HexabitzPlatform/H10R4x-Hardware/README.md

# H10R4x-Hardware
Hexabitz Thumb Joystick Module Hardware Design
