HexabitzPlatform/H10R4x-Hardware/Documentation/H10R4 Schematics.pdf

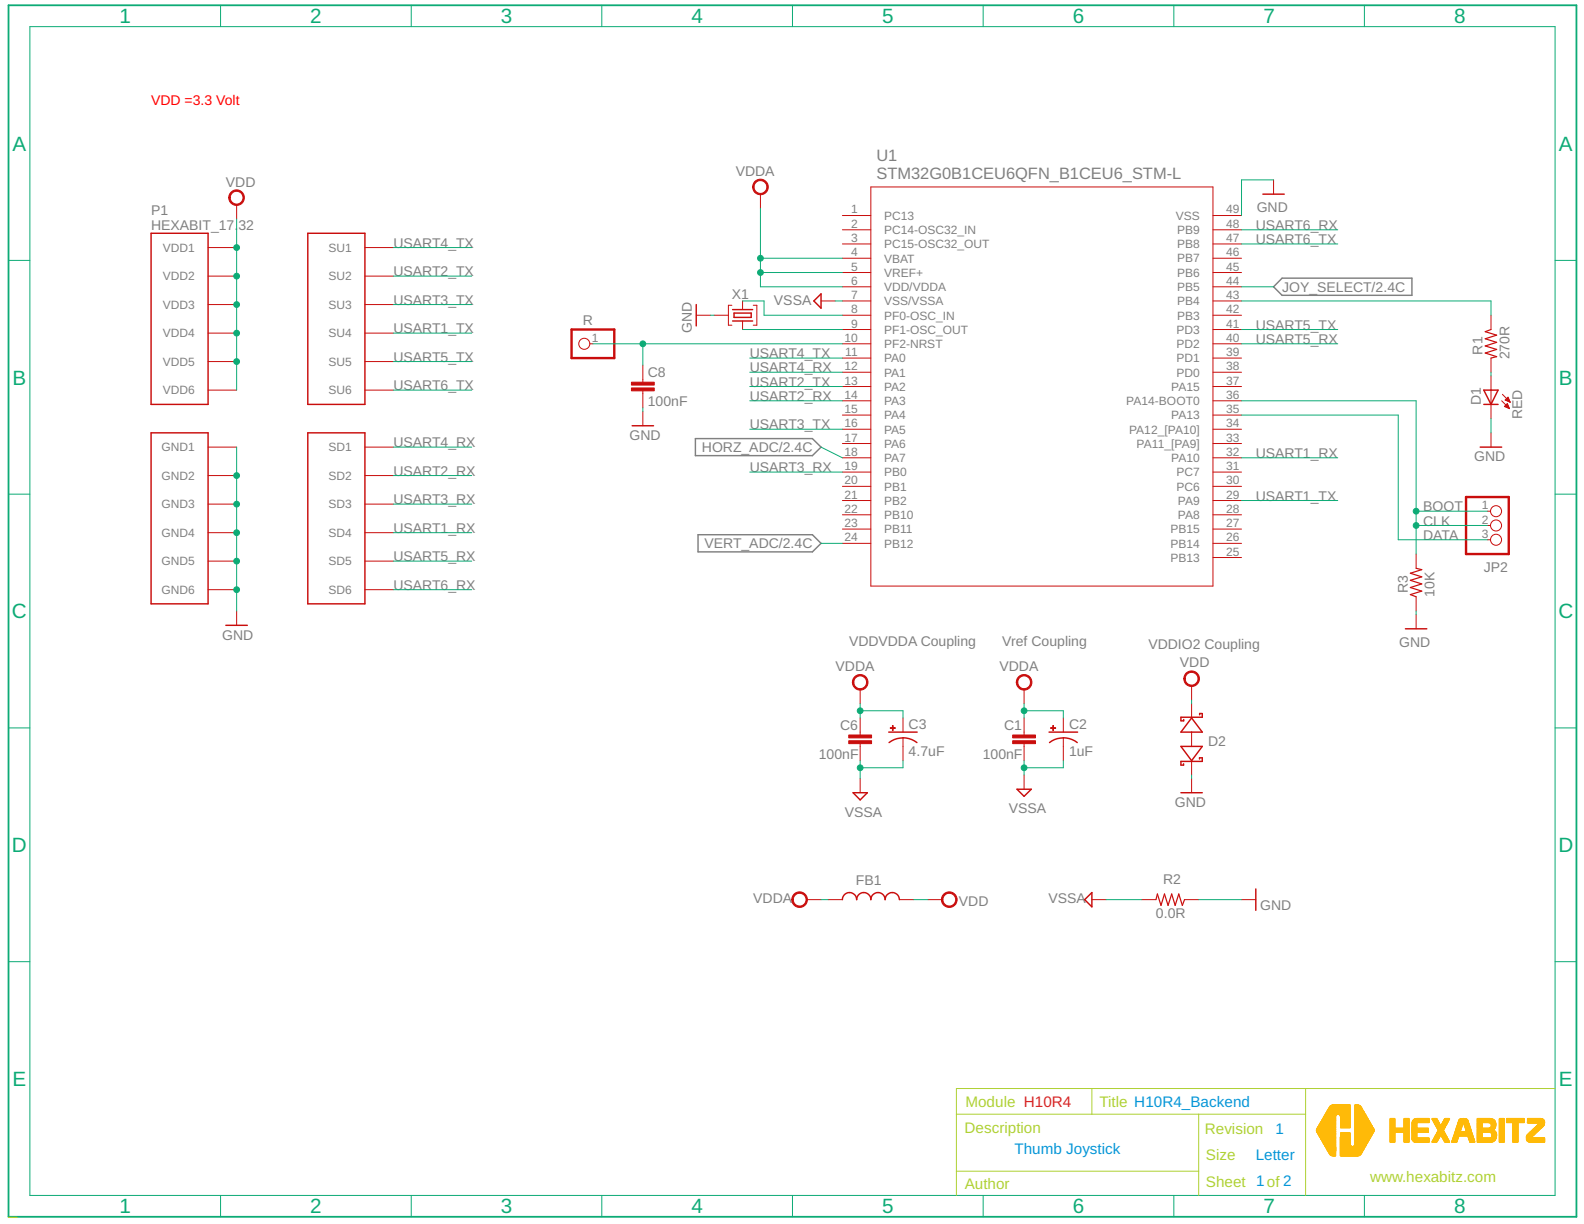
[picture p1: page 1]

Module Title Thumb Joystick | Revision Sheet Size Author Description of Letter 1 1 2

H10R4 | H10R4_Backend | www.hexabitz.com

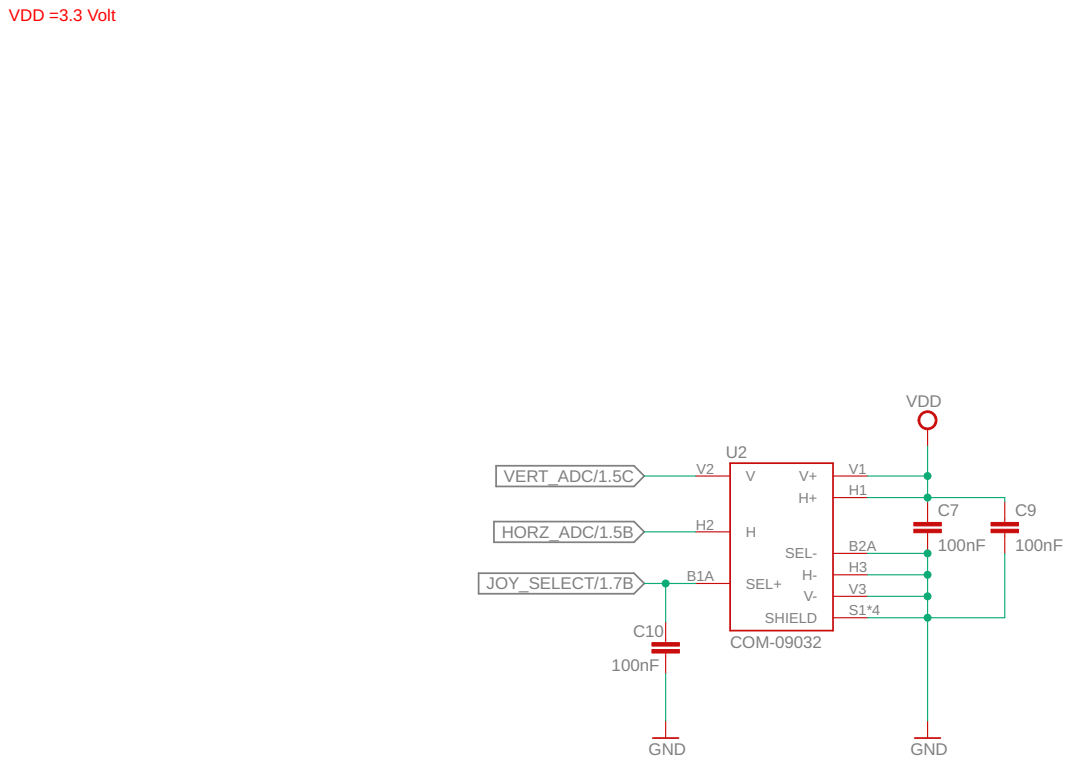
[picture p2: page 2]

Module Title Thumb Joystick | Revision Sheet Size Author Description of Letter 1 2 2

H10R4 | H10R4_Frontend | www.hexabitz.com
