HexabitzPlatform/H10R4x-Hardware/Design/H10R4.brd

## EAGLE design Design/H10R4.brd (2025-01-26)

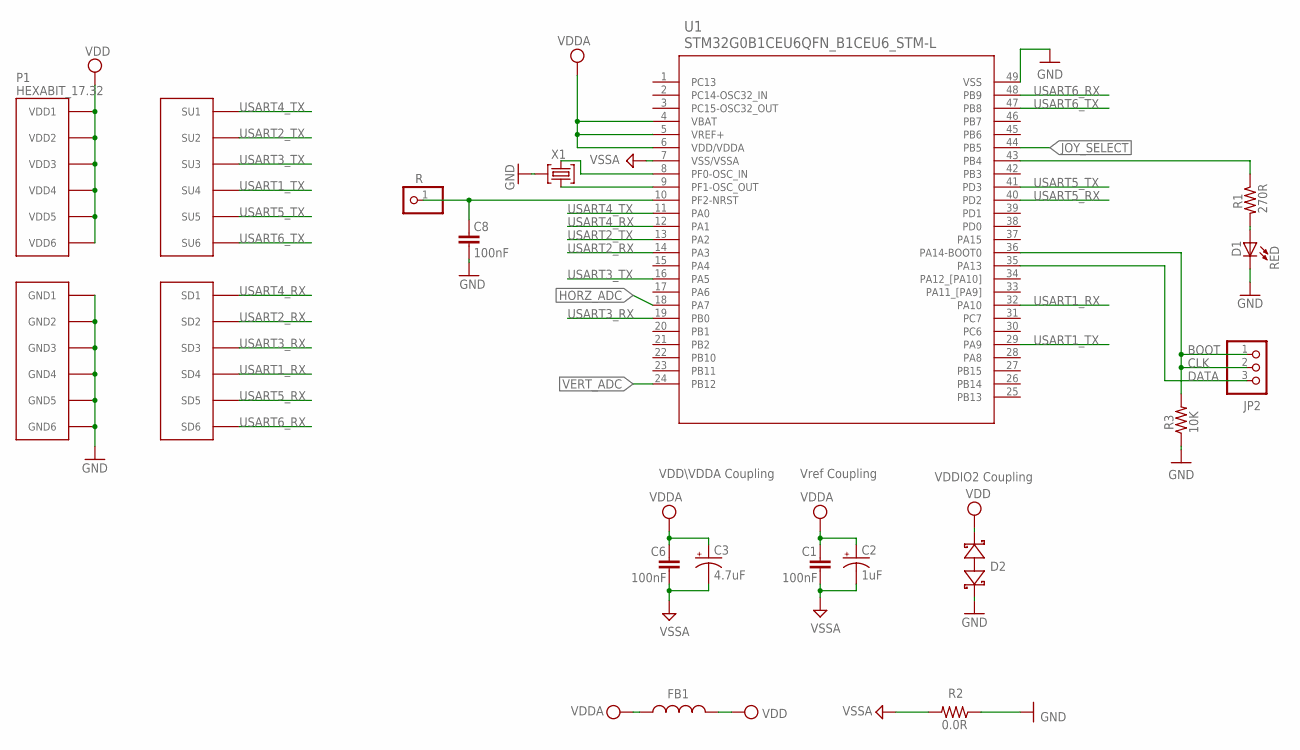
[picture p3: schematic H10R4.sch, sheet 1]

Parts:
C1, C6, C8: 100nF; C-0603
C2: 1uF; C-0805-POL
C3: 4.7uF; C-0805-POL
D1: RED; VLMS1300-GS08; MPN VLMS1300-GS08
D2: BOURNS_CDSOD323-T03SCBOURNS_CDSOD323-T03SC_0_0; BOURNS_CDSOD323-T03SC_0
FB1: FB-TDK_MMZ1608Y300B; MPN MMZ1608Y300B
JP2: PINHD-1X3; 1X03
P1: HEXABIT_17.32
R: R; 1X01
R1: 270R; R-0603
R2: 0.0R; R-0603; MPN RC0603JR-070RL
R3: 10K; R-0603
TRIMBLE-LOGO1: HEXA-LOGO
U1: STM32G0B1CEU6QFN_B1CEU6_STM-L; QFN_B1CEU6_STM-L
X1: XTALL_CSTCE8M00G52

Connections:
CLK: JP2.1, JP2.2, R3.2, U1.36 (PA14-BOOT0)
DATA: JP2.3, U1.35 (PA13)
GND: C8.2, D1.C, D2.1 (A), P1.PAD_PD7 (GND1), P1.PAD_PD8 (GND2), P1.PAD_PD9 (GND3), P1.PAD_PD10 (GND4), P1.PAD_PD11 (GND5), P1.PAD_PD12 (GND6), R2.1, R3.1, U1.49 (VSS), X1.P$2 (2); also elsewhere on the board
HORZ_ADC: U1.18 (PA7); also elsewhere on the board
JOY_SELECT: U1.44 (PB5); also elsewhere on the board
unnamed: R1.1, U1.43 (PB4)
unnamed: D1.A, R1.2
unnamed: C8.1, R.1, U1.10 (PF2-NRST)
unnamed: U1.9 (PF1-OSC_OUT), X1.P$1 (1)
unnamed: U1.8 (PF0-OSC_IN), X1.P$3 (3)
USART1_RX: P1.PAD_PD4 (SD4), U1.32 (PA10)
USART1_TX: P1.PAD_PU4 (SU4), U1.29 (PA9)
USART2_RX: P1.PAD_PD2 (SD2), U1.14 (PA3)
USART2_TX: P1.PAD_PU2 (SU2), U1.13 (PA2)
USART3_RX: P1.PAD_PD3 (SD3), U1.19 (PB0)
USART3_TX: P1.PAD_PU3 (SU3), U1.16 (PA5)
USART4_RX: P1.PAD_PD1 (SD1), U1.12 (PA1)
USART4_TX: P1.PAD_PU1 (SU1), U1.11 (PA0)
USART5_RX: P1.PAD_PD5 (SD5), U1.40 (PD2)
USART5_TX: P1.PAD_PU5 (SU5), U1.41 (PD3)
USART6_RX: P1.PAD_PD6 (SD6), U1.48 (PB9)
USART6_TX: P1.PAD_PU6 (SU6), U1.47 (PB8)
VDD: D2.2 (C), FB1.2, P1.PAD_PU7 (VDD1), P1.PAD_PU8 (VDD2), P1.PAD_PU9 (VDD3), P1.PAD_PU10 (VDD4), P1.PAD_PU11 (VDD5), P1.PAD_PU12 (VDD6); also elsewhere on the board
VDDA: C1.1, C2.1 (+), C3.1 (+), C6.1, FB1.1, U1.4 (VBAT), U1.5 (VREF+), U1.6 (VDD/VDDA)
VERT_ADC: U1.24 (PB12); also elsewhere on the board
VSSA: C1.2, C2.2 (-), C3.2 (-), C6.2, R2.2, U1.7 (VSS/VSSA)

Notes on the sheet:
Vref Coupling
VDDIO2 Coupling
VDD\VDDA Coupling
BOOT

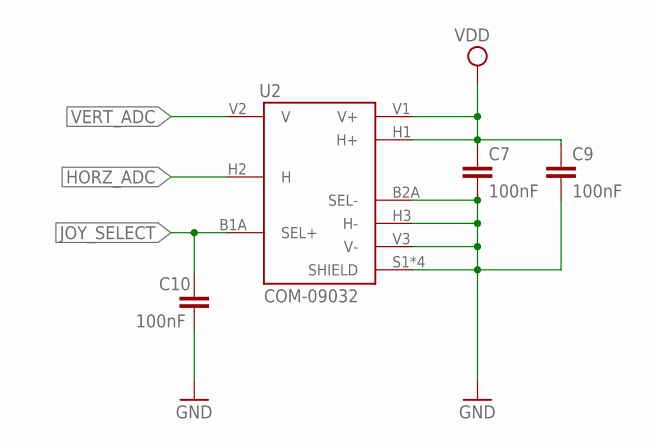
[picture p4: schematic H10R4.sch, sheet 2]

Parts:
C7, C10: 100nF; C-0603; TOLERANCE 10%; VOLTAGE_RATING 10V; MPN C0603C104K8RACTU
C9: 100nF; C-0603
U2: COM-09032; XDCR_COM-09032

Connections:
GND: C7.2, C9.2, C10.2, U2.B2A (SEL-), U2.H3 (H-), U2.S1 (SHIELD), U2.S2 (SHIELD), U2.S3 (SHIELD), U2.S4 (SHIELD), U2.V3 (V-); also elsewhere on the board
HORZ_ADC: U2.H2 (H); also elsewhere on the board
JOY_SELECT: C10.1, U2.B1A (SEL+); also elsewhere on the board
VDD: C7.1, C9.1, U2.H1 (H+), U2.V1 (V+); also elsewhere on the board
VERT_ADC: U2.V2 (V); also elsewhere on the board

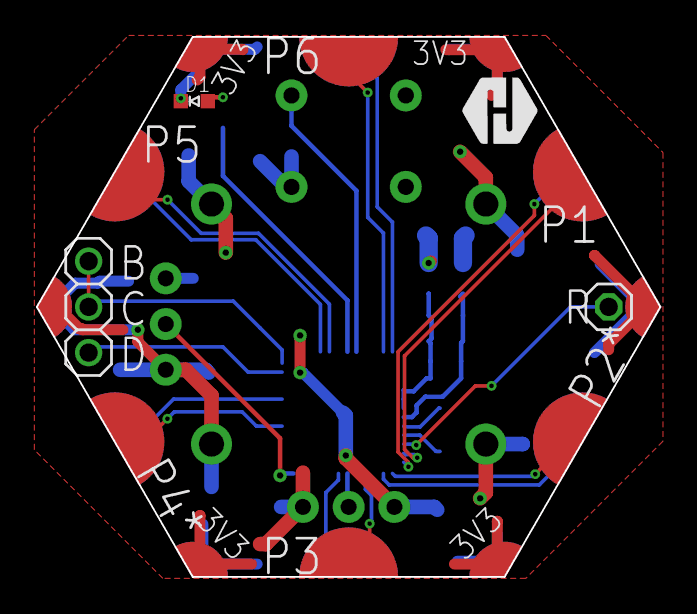
[picture p5: board H10R4.brd from above]

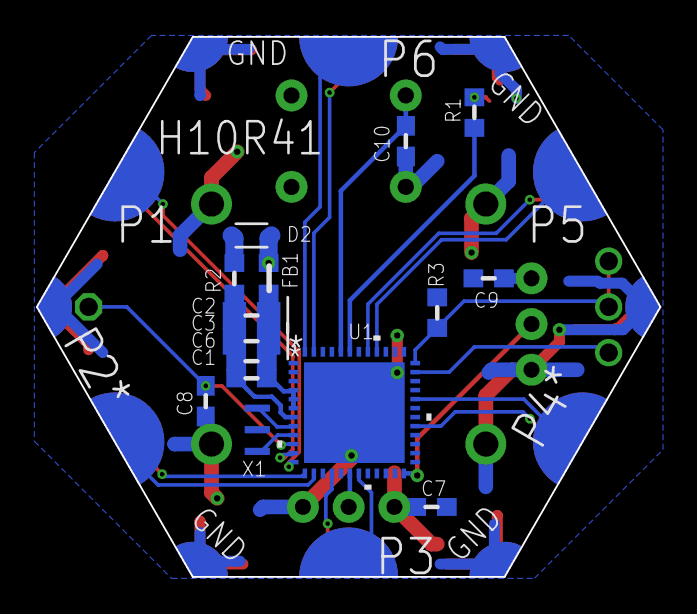
[picture p6: board H10R4.brd from below]

Board: 2 copper layers, 34.6 x 30.0 mm, 21 parts (15 on the bottom side), 26 nets.
