HexabitzPlatform/H10R4x-Hardware/(commit log)

2019-05-23 First release rev 0
    [H10R4.brd, H10R4.sch, H10R4.xlsx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]
2019-08-06 Update H10R4.xlsx
    Updating BOM
    [H10R4.xlsx]
2019-08-08 Update H10R4.pdf
    Updated schematics to fix colors
2025-01-26 -Add TVS diode -Change the MCU to STM32G0B1CEU6 -Activate the thermal option for the polygon -Improve the layout design for better performance
    [H10R4.brd, H10R4.sch, H10R4.xlsx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]
